adafruit/Adafruit-PC-Joystick-to-seesaw-PCB/Adafruit PC Joystick seesaw Breakout.brd

## EAGLE design Adafruit PC Joystick seesaw Breakout.brd (2023-08-07)

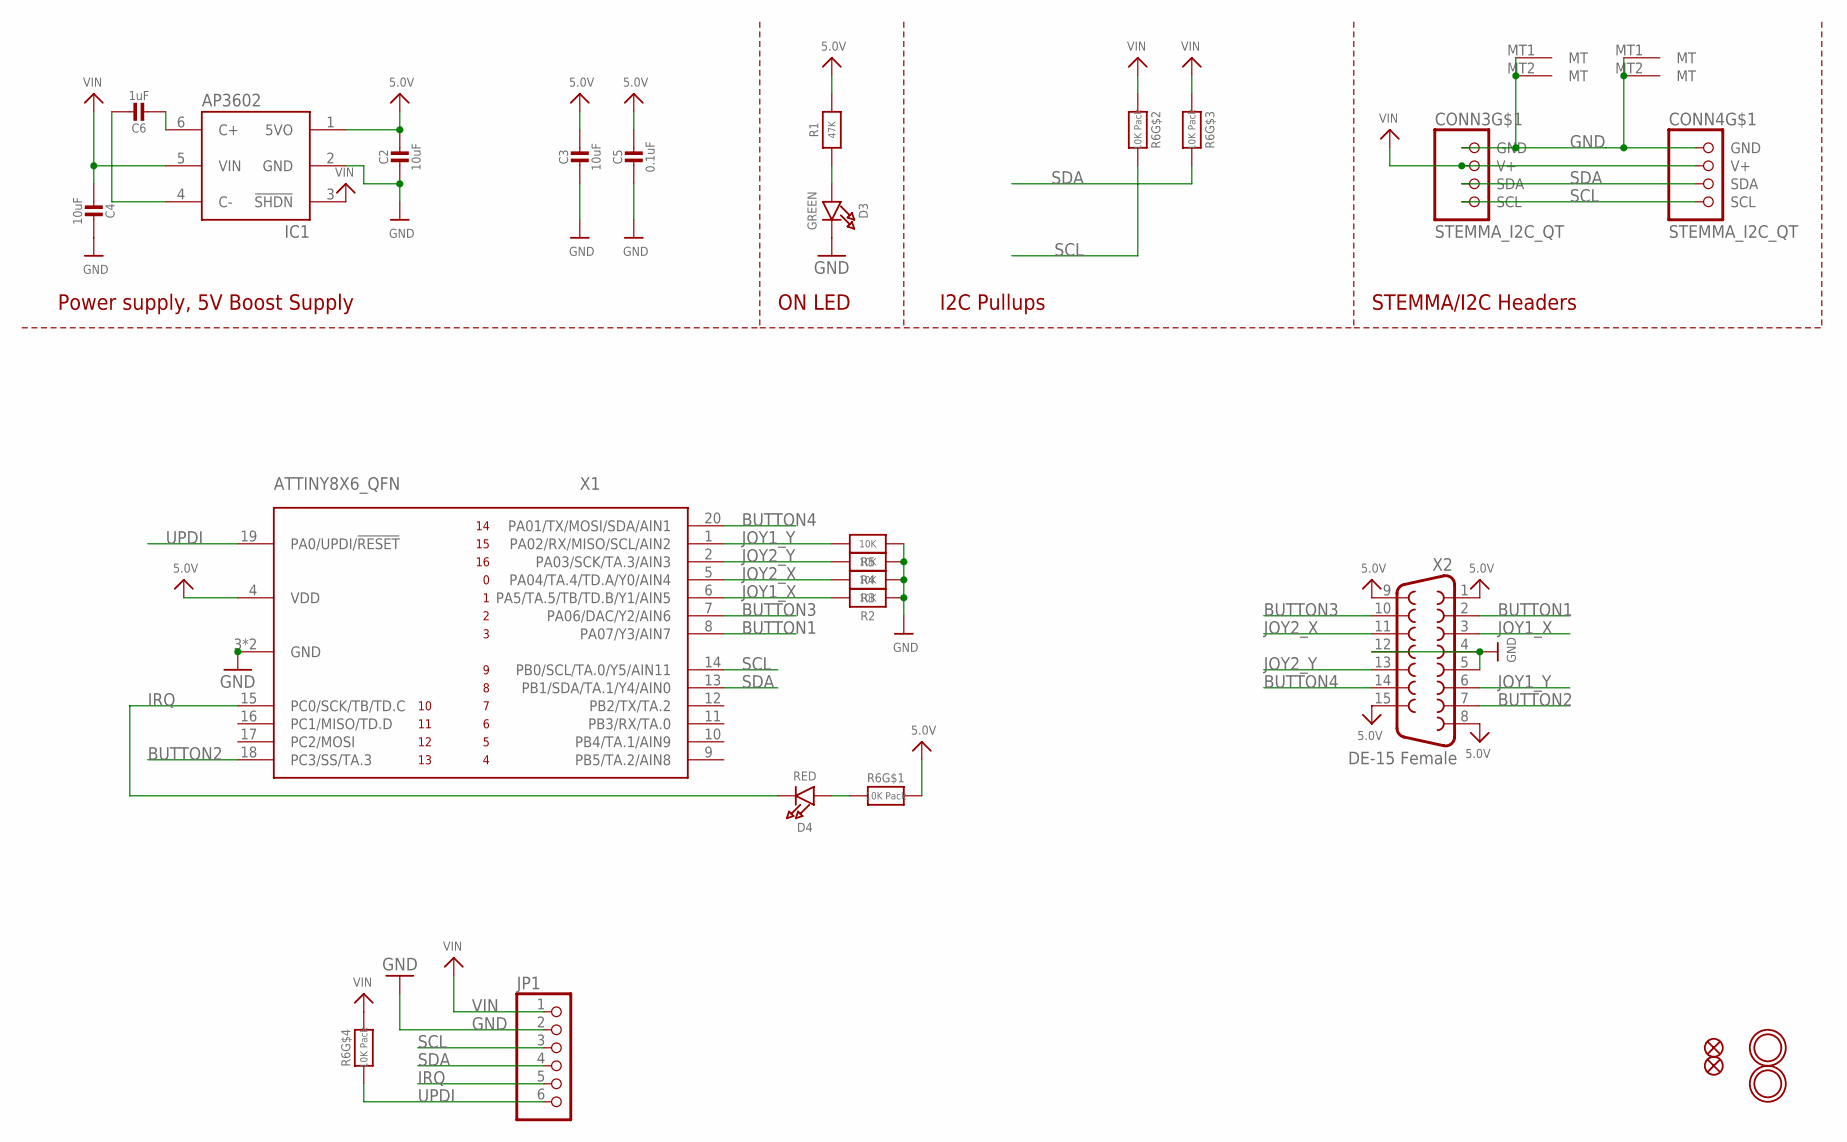
[picture p2: schematic Adafruit PC Joystick seesaw Breakout.sch]

Parts:
C2, C3, C4: 10uF; 0805-NO
C5: 0.1uF; 0603-NO
C6: 1uF; 0603-NO
CONN3, CONN4: STEMMA_I2C_QT; JST_SH4
D3: GREEN; CHIPLED_0603_NOOUTLINE
D4: RED; CHIPLED_0603_NOOUTLINE
FID1, FID2: FIDUCIAL_1MM
IC1: AP3602; SOT23-6
JP1: HEADER-1X670MIL; 1X06_ROUND_70
R1: 47K; 0603-NO
R2, R3, R4, R5: 10K; 0603-NO
R6: 10K Pack; RESPACK_4X0603
U$6, U$18: MOUNTINGHOLE2.5; MOUNTINGHOLE_2.5_PLATED
X1: ATTINY8X6_QFN; QFN20_3MM
X2: DE-15 Female; F15H

Connections:
5.0V: C2.1, C3.1, C5.1, IC1.1 (5VO), R1.2, R6.8 (2), X1.4 (VDD), X2.1, X2.8, X2.9, X2.15
BUTTON1: X1.8 (PA07/Y3/AIN7), X2.2
BUTTON2: X1.18 (PC3/SS/TA.3), X2.7
BUTTON3: X1.7 (PA06/DAC/Y2/AIN6), X2.10
BUTTON4: X1.20 (PA01/TX/MOSI/SDA/AIN1), X2.14
GND: C2.2, C3.2, C4.2, C5.2, CONN3.1 (GND), CONN3.MT1 (MT), CONN3.MT2 (MT), CONN4.1 (GND), CONN4.MT1 (MT), CONN4.MT2 (MT), D3.C, IC1.2 (GND), JP1.2, R2.1, R3.1, R4.1, R5.1, X1.3 (GND), X1.PAD (GND), X2.4, X2.5, X2.12
IRQ: D4.C, JP1.5, X1.15 (PC0/SCK/TB/TD.C)
JOY1_X: R2.2, X1.6 (PA5/TA.5/TB/TD.B/Y1/AIN5), X2.3
JOY1_Y: R5.2, X1.1 (PA02/RX/MISO/SCL/AIN2), X2.6
JOY2_X: R3.2, X1.5 (PA04/TA.4/TD.A/Y0/AIN4), X2.11
JOY2_Y: R4.2, X1.2 (PA03/SCK/TA.3/AIN3), X2.13
unnamed: D3.A, R1.1
unnamed: C6.2, IC1.6 (C+)
unnamed: C6.1, IC1.4 (C-)
unnamed: D4.A, R6.1
SCL: CONN3.4 (SCL), CONN4.4 (SCL), JP1.3, R6.7 (2), X1.14 (PB0/SCL/TA.0/Y5/AIN11)
SDA: CONN3.3 (SDA), CONN4.3 (SDA), JP1.4, R6.6 (2), X1.13 (PB1/SDA/TA.1/Y4/AIN0)
UPDI: JP1.6, R6.4 (1), X1.19 (PA0/UPDI/!RESET)
VIN: C4.1, CONN3.2 (V+), CONN4.2 (V+), IC1.3 (!SHDN), IC1.5 (VIN), JP1.1, R6.2 (1), R6.3 (1), R6.5 (2)

Notes on the sheet:
I2C Pullups
STEMMA/I2C Headers
ON LED
Power supply, 5V Boost Supply

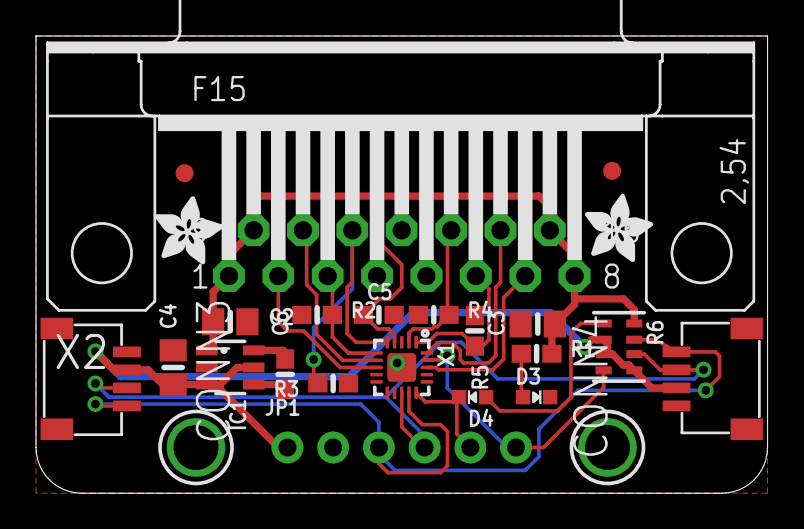
[picture p3: board Adafruit PC Joystick seesaw Breakout.brd from above]

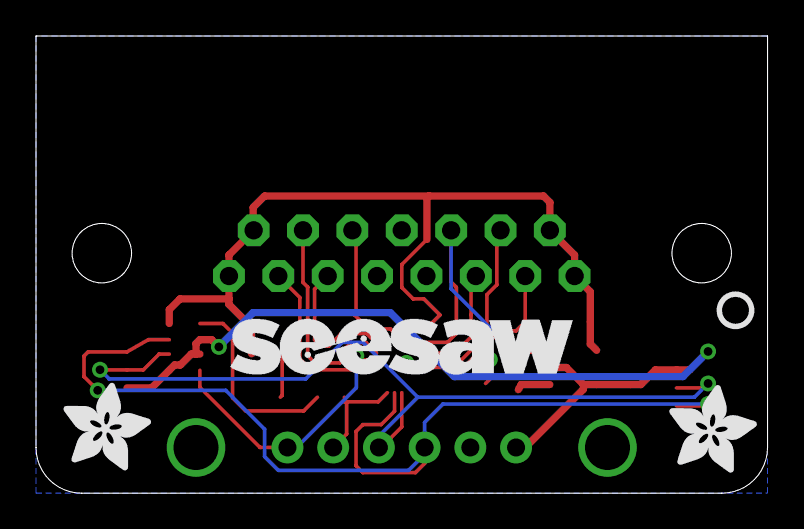
[picture p4: board Adafruit PC Joystick seesaw Breakout.brd from below]

Board: 2 copper layers, 40.6 x 25.4 mm, 41 parts (8 on the bottom side), 19 nets.

Other parts of the board:
PLABEL0: PLABEL0
PLABEL1: PLABEL1
PLABEL2: PLABEL2
PLABEL3: PLABEL3
PLABEL4: PLABEL4
PLABEL5: PLABEL5
PLABEL6: PLABEL6
PLABEL7: PLABEL7
PLABEL8: PLABEL8
PLABEL9: PLABEL9
PLABEL10: PLABEL10
PLABEL11: PLABEL11
U$7: SEESAW_LOGO
U$12: PCBFEAT-REV-040
U$20, U$32: ADAFRUIT_5MM
U$30, U$31: ADAFRUIT_3.5MM
